ErlyAquino/telemetria-cria/(commit log)

2026-09-25 Cria o repositório do software de telemetria do Espaço CRIA
    README com arquitetura, plano em fases (Arduino via USB, depois ESP32 via
    Wi-Fi), formato das mensagens e regras de contribuição. Estrutura de pastas
    para firmware, gateway, backend e frontend. Licença MIT.
2026-09-25 Adiciona tutorial de conta no GitHub e Git no terminal para os alunos
2026-09-25 Gera o tutorial de Git e GitHub em PDF e ODT
2026-10-18 Alinha o repositório ao Guia do Projeto (Etapa 0)
    - Adota a estrutura de pastas do Guia: firmware/biblioteca-cria, servidor/src
    e servidor/painel, mqtt, modelos-3d, calibracao, validacao, decisoes,
    tutoriais e caderno; o gateway fica como caminho das placas Arduino legadas.
    - Cria o catálogo de tópicos v0 (cria/{projeto}/{no}/{grandeza}), com o
    formato das mensagens (valor, unidade, seq, boot, t, fila), o tópico de
    status, os projetos ar, horta e teste e a regra de ACL por projeto.
    - Registra as duas primeiras decisões técnicas: iluminância no lugar de
    irradiância e leituras em QoS 0 com seq e boot.
    - Acrescenta o LICENSE-DOCS (CC BY 4.0) e o modelo credenciais.exemplo.h;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
2026-10-18 Instala o servidor base e cria o nó simulado (Etapa 1)
    - Configuração do Mosquitto sem senhas (mqtt/mosquitto.exemplo.conf):
    conexão só com usuário e senha, ACL por projeto (mqtt/acl) e fila de
    leituras para quem assina com sessão persistente.
    - chrony como servidor de hora da rede local, funcionando sem internet.
    - servidor/base/instalar.sh instala Mosquitto, chrony e InfluxDB 2 num
    Ubuntu ou Debian, cria os usuários servidor, ar, horta e teste, o bucket
    telemetria e um token só para ele, grava as senhas no .env (600) e faz um
    autoteste da ACL e da recusa sem senha.
    - servidor/ferramentas/no-simulado.js imita os nós do catálogo, com LWT,
    seq, boot, fila com reenvio ma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
2026-10-18 Cria o servidor da telemetria e o painel ao vivo (Etapa 2)
    - Servidor em Node.js (Fastify 5): assina cria/# com sessão persistente,
    confere cada mensagem contra o catálogo, grava no InfluxDB com a hora da
    leitura e repassa ao painel pelo Socket.IO.
    - Painel sem etapa de compilação, com Chart.js servido localmente: um cartão
    por nó com status, perda estimada e gráfico da última hora por grandeza.
    Com ?medir=1, mede a latência do critério 2 no próprio servidor.
    - Exportação em CSV no padrão brasileiro (ou internacional), rota HTTP
    autenticada para as placas Arduino e /saude para o teste de
    disponibilidade.
    - Regras do catálogo endurecidas: nomes sem hífen inicial, u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
2026-10-19 Cria a biblioteca CriaTelemetria e o nó de ar (Etapa 3)
    - Biblioteca-padrão dos nós ESP32 (firmware/biblioteca-cria, versão 0.1.0):
    Wi-Fi com nova tentativa a cada 30 s sem rede, MQTT com LWT e status
    online, keepalive de 5 s, hora pelo NTP do servidor conferida a cada
    15 min, seq dado na leitura, boot na memória não volátil e fila em
    LittleFS reenviada com "fila":1, inclusive depois de reiniciar.
    - Regras do catálogo e formato da mensagem num arquivo sem dependência de
    hardware (CriaFormato), iguais às do servidor.
    - Exemplo PrimeiroNo (DHT22 em cria/teste/no1) e o nó do monitor de ar
    (firmware/no-ar): MQ-2 e MQ-135 em Rs/R0 só depois de calibrar o R0,
    MH-Z19B pela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
2026-10-19 Cria as ferramentas do teste de aceitação (Etapa 6)
    - npm run disponibilidade: consulta o /saude periodicamente e grava cada
    resposta em validacao/dados/, com o intervalo e a diferença de relógio
    em relação ao servidor.
    - npm run relatorio: gera validacao/relatorio-validacao.md com os seis
    critérios. Perda e latência vêm do InfluxDB, disponibilidade dos
    arquivos do verificador, pH, condutividade e reuso de
    validacao/medidas-manuais.json. O período é lido na hora da escola.
    - Cálculos em servidor/src/validacao.js, com testes: perda por seq em cada
    boot (desde o seq 1 nos boots que começam no período), disponibilidade
    por janelas, latência no percentil 95 com cober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
2026-10-19 Cria o gateway USB das placas Arduino e o programa da placa (Etapa 4)
    - gateway/gateway.py: lê as linhas JSON da placa pela serial e as envia
    em lote para POST /api/leituras, com o usuário e a senha do projeto.
    A leitura da serial roda numa linha de execução própria e marca a hora
    de cada linha na chegada, sempre crescente em cada série; o envio
    continua com a placa desconectada.
    - Boot criado pelo gateway: muda só quando o seq volta. O último boot e o
    último seq ficam em gateway/.estado/, um arquivo por nó, com trava
    contra dois gateways no mesmo nó e parada se o arquivo estiver
    corrompido.
    - Servidor fora do ar: as leituras esperam na memória (até 20000), com
    e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
2026-10-19 Cria o backend da horta: nós, calibração, câmera e backup (Etapa 5)
    - Biblioteca CriaTelemetria 0.2: hora pelo RTC DS3231 depois de um corte
    de energia sem rede, corrigida a cada resposta do servidor; keepalive
    configurável; classe CriaCalibracao, que guarda a reta de cada sensor
    na memória do nó e atende os comandos "cal" pela USB, com as retas do
    modo simulado num espaço separado da memória.
    - firmware/horta-no1: pH, condutividade (com compensação de temperatura),
    temperatura, vazão, pressão, nível e bomba. Corta a bomba pelo contato
    NF do relé quando a solução fica abaixo da boia, sem depender da rede;
    leitura do ADS1115 com prazo e cão de guarda de 15 s. M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
    [CriaCalibracao.cpp, CriaCalibracao.h, CriaFormato.cpp, CriaFormato.h, CriaTelemetria.cpp, CriaTelemetria.h, calibrar.py]
2026-10-19 Cria o guia completo da plataforma, em Markdown, HTML e PDF
    - tutoriais/02-guia-completo.md: da instalação ao nó pelo Wi-Fi. Parte I:
    o servidor (instalar.sh, npm start, backup, servidor de teste no WSL) e
    o computador de desenvolvimento no Windows e no Linux (Arduino IDE,
    Python e pyserial, porta serial e drivers). Parte II: a placa escrevendo
    as leituras na serial e o gateway enviando ao painel, com capturas reais
    de uma ESP32 com DS18B20. Parte III: a biblioteca CriaTelemetria, o nó
    publicando por MQTT, a calibração pela USB, os dados, os problemas
    comuns e a referência rápida.
    - tutoriais/gerar-documentos.py: gera o HTML num arquivo só (pandoc, com
    as imagens e o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
    [NoDS18B20.ino]
2026-10-20 Adiciona perfis de aparência ao painel, com o perfil retrô (tela CRT)
    O seletor "Aparência", no alto do painel, troca entre o perfil padrão,
    que continua como estava, e o perfil retrô: letreiro em tela CRT, com
    fundo preto e linhas de varredura, números em verde neon, nomes em
    vermelho e a unidade de medida em destaque, com brilho. Cada caixa de
    medida tem fundo de matriz de pontos, como um painel de LED.
    - O perfil é o atributo data-perfil do <html>. As regras do retrô ficam
    em servidor/painel/retro.css, todas sob esse atributo; painel.css
    segue sendo o padrão.
    - As cores dos gráficos vêm das variáveis CSS do perfil e mudam na hora
    da troca, sem recarregar.
    - A escolha fi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
